Jelte-Boumans/charlieplexed-horloge/Schemas/Horloge.kicad_pcb

## KiCad design Schemas/Horloge.kicad_pcb (2023-07-24)

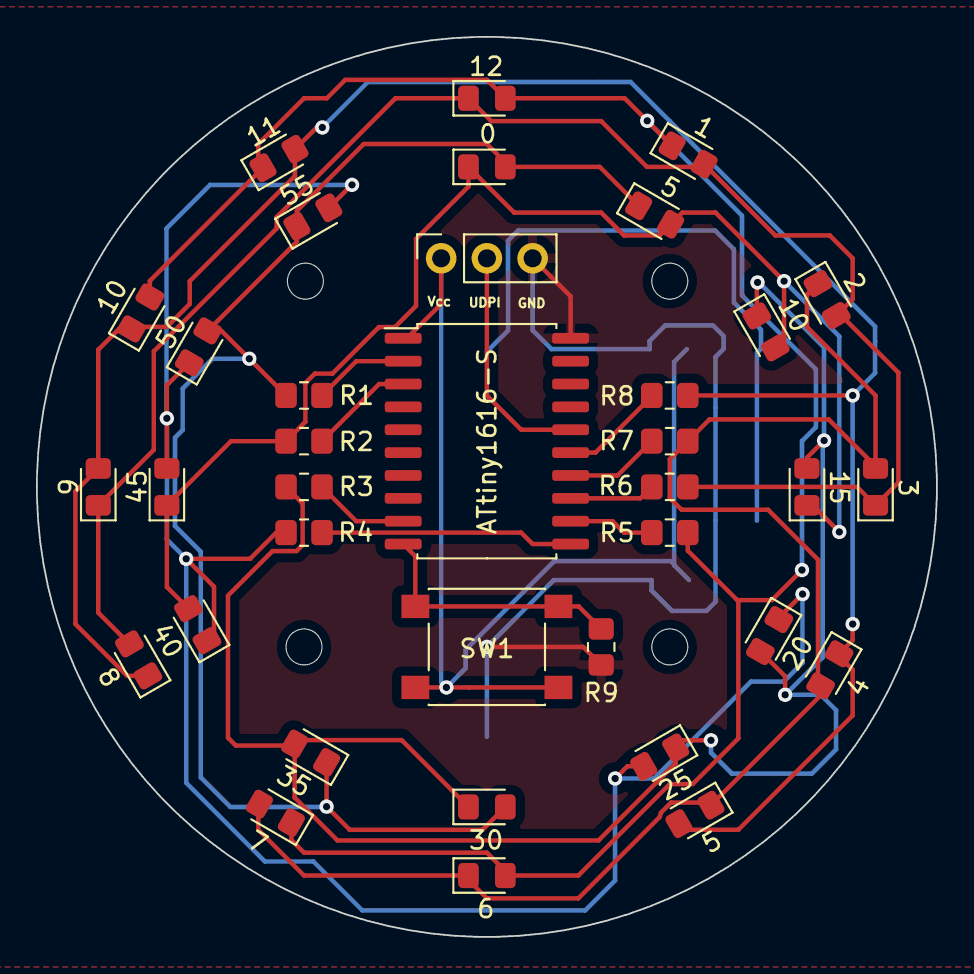
[picture p5: board Horloge.kicad_pcb from above]

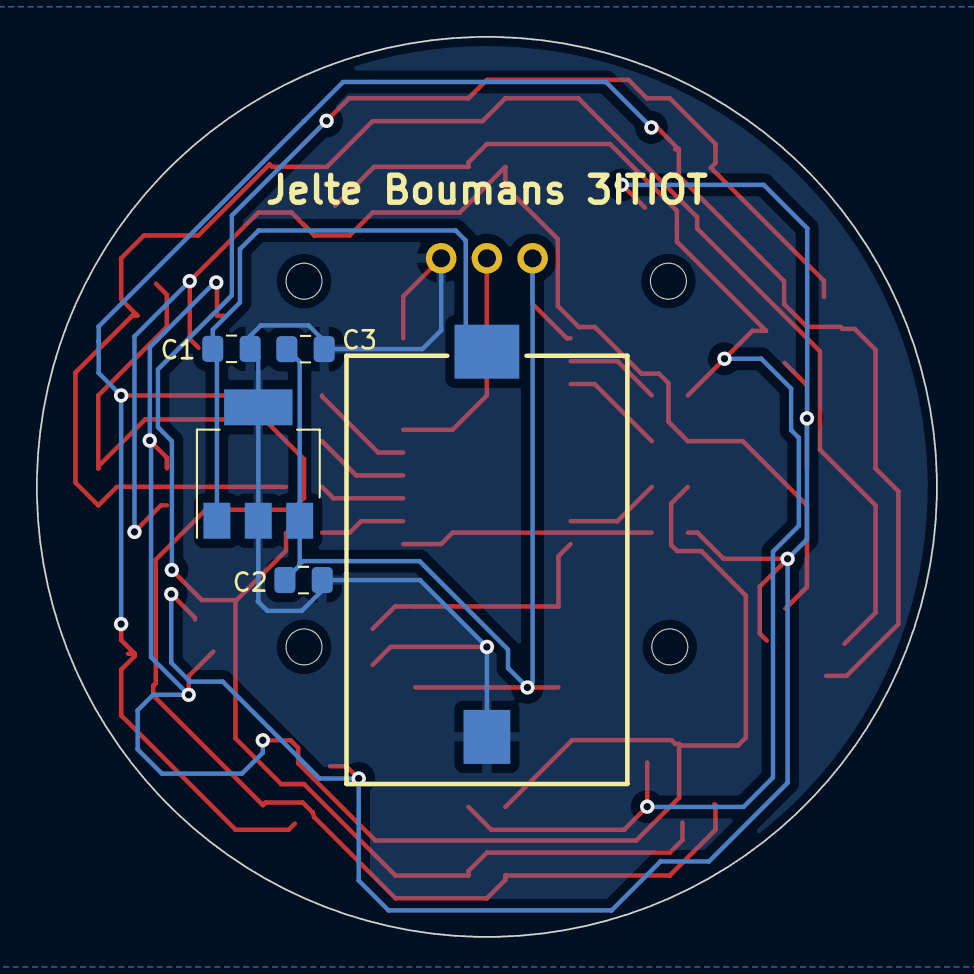
[picture p6: board Horloge.kicad_pcb from below]

Board: 2 copper layers, 50.0 x 50.0 mm, 41 parts (5 on the bottom side), 21 nets.

Parts:
0, 1, 2, 3, 4, 5, 5#2, 6, 7, 8, 9, 10, 10#2, 11, 12, 15, 20, 25, 30, 35, 40, 45, 50, 55: LED; LED_0805_2012Metric_Pad1.15x1.40mm_HandSolder
BTe: Battery_Cell; S8421-45R_1
C1, C2: 1uF; C_0805_2012Metric_Pad1.18x1.45mm_HandSolder
C3: 100nF; C_0805_2012Metric_Pad1.18x1.45mm_HandSolder
J1: Conn_01x03_Female; PinSocket_1x03_P2.54mm_Vertical
R1, R2, R3, R4: 120Ω; R_0805_2012Metric_Pad1.20x1.40mm_HandSolder
R5, R6, R7, R8: 150Ω; R_0805_2012Metric_Pad1.20x1.40mm_HandSolder
R9: 1kΩ; R_0805_2012Metric_Pad1.20x1.40mm_HandSolder
SW1: SW_Push; SW_Push_1P1T_NO_6x6mm_H9.5mm
U1: ATtiny1616-S; SOIC-20W_7.5x12.8mm_P1.27mm
U2: AP7361C-33E; SOT-223-3_TabPin2

Connections:
GND: BTe.2 (-), C1.2, C2.2, C3.2, J1.3, R9.2, U1.20 (GND), U2.2 (GND)
unnamed: BTe.1 (+), C1.1, U2.1 (VI)
unnamed: 0.1 (K), 5#2.2 (A), 10#2.2 (A), 15.1 (K), 40.2 (A), 45.1 (K), R2.1
unnamed: 0.2 (A), 5#2.1 (K), 30.2 (A), 35.1 (K), 50.2 (A), 55.1 (K), R1.1
unnamed: 10#2.1 (K), 15.2 (A), 20.2 (A), 25.1 (K), 30.1 (K), 35.2 (A), R3.1
unnamed: 20.1 (K), 25.2 (A), 40.1 (K), 45.2 (A), 50.1 (K), 55.2 (A), R4.1
unnamed: 1.2 (A), 2.2 (A), 3.1 (K), 8.2 (A), 9.1 (K), 12.1 (K), R6.1
unnamed: 1.1 (K), 6.2 (A), 7.1 (K), 10.2 (A), 11.1 (K), 12.2 (A), R5.1
unnamed: 2.1 (K), 3.2 (A), 4.2 (A), 5.1 (K), 6.1 (K), 7.2 (A), R7.1
unnamed: 4.1 (K), 5.2 (A), 8.1 (K), 9.2 (A), 10.1 (K), 11.2 (A), R8.1
PA0 UDPI: J1.2, U1.16 (~RESET/PA0)
PA4~: R1.2, U1.2 (PA4)
PA5~: R2.2, U1.3 (PA5)
PB0~: R4.2, U1.11 (PB0)
PB1: R9.1, SW1.1, U1.10 (PB1)
PB2~: R3.2, U1.9 (PB2)
PC0: R5.2, U1.12 (PC0)
PC1: R6.2, U1.13 (PC1)
PC2: R7.2, U1.14 (PC2)
PC3: R8.2, U1.15 (PC3)
Vcc: C2.1, C3.1, J1.1, SW1.2, U1.1 (VCC), U2.3 (VO)
