Jelte-Boumans/charlieplexed-horloge/Documentatie/Testplant Jelte Horloge.xlsx

Fase 1: Voeding
Soldeer volgorde | Component naam | Test proces
1 | LD1117S33 | Meten van uitgangspanning op U2 pin 3 bij een aangesloten spanning van 5V, 3.3V en 2.5V. (2.5V = laagste batterijspanning)
2 | C1 - C3
3 | Batterij
Fase 2: Microcontroller
Soldeer volgorde | Component naam | Test proces
1 | ATTiny1616 | Prgramming pins en voeding traces doormeten. Daarna software uploaden dat de drukknop en RTC zal testen op verschillende voedingspanningen (3.3V en 2.5V).
2 | R9
3 | SW1
4 | UDPI pins
Fase 3: LEDs
Soldeer volgorde | Component naam | Test proces
1 | R1 - R4 | Software uploaden dat de LEDs zal testen op verschillende voedingspanningen (3.3V en 2.5V).
2 | D1 - D8 (minuten)
3 | R5 - R8
4 | D9 - D16 (uren)
